jetkov/canary-pcb/Fabrication/PCBWay Gerbers/Canary-BOM-Processed.xlsx

Reference(s) | Value | Qty | Part Number | Manufacturer | Description
C1, C2, C4, C8, C11, C12, C14, C17 | 0.1u | 8 | CL05A104KP5NNNC | Samsung Electro-Mechanics | CAP CER 0.1UF 10V X5R 0402
C3, C9, C10, C15, C19, C23, C26 | 1u | 7 | CL05A105KP5NNNC | Samsung Electro-Mechanics | CAP CER 1UF 10V X5R 0402
C6, C7 | 12pF | 2 | CL05C120JB5NNNC | Samsung Electro-Mechanics | CAP CER 12PF 50V C0G/NP0 0402
C18, C20 | 10u | 2 | CL10A106MP8NNNC | Samsung Electro-Mechanics | CAP CER 10UF 10V X5R 0603
C21, C24 | 4.7u | 2 | CL05A475MP5NRNC | Samsung Electro-Mechanics | CAP CER 4.7UF 10V X5R 0402
C22, C25 | 22u | 2 | GRM188R61A226ME15D | Murata Electronics | CAP CER 22UF 10V X5R 0603
D1 | GREEN | 1 | 155124VS73200 | Wurth Elektronik | LED GREEN CLEAR 1204 SMD R/A
D2 | YELLOW | 1 | 155124YS73200 | Wurth Elektronik | LED YELLOW CLEAR 1204 SMD R/A
D3 | RED | 1 | 155124RS73200 | Wurth Elektronik | LED RED CLEAR 1204 SMD R/A
D4 | D_Schottky | 1 | PMEG2010EA,135 | Nexperia USA Inc. | DIODE SCHOTTKY 20V 1A SOD323
D5, D6, D7 | D_Schottky_ALT | 3 | NSPU3051N2T5G | ON Semiconductor | TVS DIODE 5.5V 9.5V 2X2DFN
J3 | USB4125-GF-A | 1 | USB4125-GF-A | GCT | USB C REC, GF, RA, 6P, SMT, TH S
J4 | S2B-PH-SM4-TB | 1 | S2B-PH-SM4-TB(LF)(SN) | JST Sales America Inc. | CONN HEADER SMD R/A 2POS 2MM
L1 | 2.2u | 1 | MAMK2520T2R2M | Taiyo Yuden | FIXED IND 2.2UH 1.9A 117 MOHM
L2 | 4.7u | 1 | LQH3NPZ4R7MMEL | Murata Electronics | FIXED IND 4.7UH 1A 120 MOHM SMD
LS1 | PKMCS0909E4000-R1 | 1 | PKMCS0909E4000-R1 | Murata Electronics | AUDIO PIEZO TRANSDUCER 12.5V SMD
Q1, Q3 | PMN30UNX | 2 | PMN30UNX | Nexperia USA Inc. | MOSFET N-CH 30V 4.5A 6TSOP
Q2 | PMN42XPEAH | 1 | PMN42XPEAH | Nexperia USA Inc. | MOSFET P-CH 20V 5.7A 6TSOP
R1, R13, R18, R26 | 2M | 4 | RMCF0402FT2M00 | Stackpole Electronics Inc | RES 2M OHM 1% 1/16W 0402
R2 | 2.4M | 1 | RMCF0402FT2M40 | Stackpole Electronics Inc | RES 2.4M OHM 1% 1/16W 0402
R3, R5, R6, R24 | 180k | 4 | RMCF0402FT180K | Stackpole Electronics Inc | RES 180K OHM 1% 1/16W 0402
R4, R7, R27 | 10k | 3 | RMCF0402FT10K0 | Stackpole Electronics Inc | RES 10K OHM 1% 1/16W 0402
R8, R9, R10, R11 | 470R | 4 | RMCF0402FT470R | Stackpole Electronics Inc | RES 470 OHM 1% 1/16W 0402
R12 | 499R | 1 | RMCF0402FT499R | Stackpole Electronics Inc | RES 499 OHM 1% 1/16W 0402
R15 | 499k | 1 | RMCF0402FT499K | Stackpole Electronics Inc | RES 499K OHM 1% 1/16W 0402
R16 | 49R9 | 1 | RMCF0402FT49R9 | Stackpole Electronics Inc | RES 49.9 OHM 1% 1/16W 0402
R19, R20 | 5.1k | 2 | RMCF0402FT5K10 | Stackpole Electronics Inc | RES 5.1K OHM 1% 1/16W 0402
R21, R30 | 487k | 2 | RMCF0402FT487K | Stackpole Electronics Inc | RES 487K OHM 1% 1/16W 0402
R22 | 86.6k | 1 | RMCF0402FT86K6 | Stackpole Electronics Inc | RES 86.6K OHM 1% 1/16W 0402
R23 | 300k | 1 | RMCF0402FT300K | Stackpole Electronics Inc | RES 300K OHM 1% 1/16W 0402
R25 | 0R | 1 | RMCF0402ZT0R00 | Stackpole Electronics Inc | RES 0 OHM JUMPER 1/16W 0402
R28 | 9.1k | 1 | RMCF0402FT9K10 | Stackpole Electronics Inc | RES 9.1K OHM 1% 1/16W 0402
R29 | 3k | 1 | RMCF0402FT3K00 | Stackpole Electronics Inc | RES 3K OHM 1% 1/16W 0402
U1 | BMD-300-A-R | 1 | BMD-300-A-R | U-Blox | RX TXRX MOD BLE 5.0 NORDIC SMD
U3 | SHTC3 | 1 | SHTC3 | Sensirion AG | SENSOR HUMI/TEMP I2C 2% SMD
U4 | SGP40 | 1 | SGP40-D-R4 | Sensirion AG | AIR QUALITY GAS SENSOR FOR VOC'S
U5 | MAX6071BAUT21T | 1 | MAX6071BAUT21+T | Maxim Integrated | IC VREF SERIES 0.08% SOT23-6
U6 | LMP91000 | 1 | LMP91000SD/NOPB | Texas Instruments | IC AFE 1 CHAN 8BIT 14WSON
U8 | MCP6041T-I_OT | 1 | MCP6041T-I/OT | Microchip Technology | IC OPAMP GP 1 CIRCUIT SOT23-5
U9 | RT6150AGQW | 1 | RT6150AGQW | Richtek USA Inc. | IC REG BCK BST ADJ 800MA 10WDFN
U10 | LP5907MFX-3.2 | 1 | LP5907MFX-3.2/NOPB | Texas Instruments | IC REG LINEAR 3.2V 250MA SOT23-5
U11 | MCP73831T-2ATI_OT | 1 | MCP73831T-2ATI/OT | Microchip Technology | IC BATT CNTL LI-ION 1CEL SOT23-5
U12 | MIC2288YD5 | 1 | MIC2288YD5-TR | Microchip Technology | IC REG BOOST ADJ 1.2A TSOT23-5
Y1 | 32.7680 kHz | 1 | ECS-.327-9-12-C-TR | ECS Inc. | CRYSTAL 32.7680KHZ 9PF 10PPM SMD
J1 | DNP | 1
J2 | DNP | 1
SW1 | DNP | 1
C5, C13, C16 | DNP | 3
R14, R17 | DNP | 2
S1 | DNP | 1
U2 | DNP | 1
U7 | DNP | 1
FID1, FID2, FID3, FID4, FID5, FID6 | Fiducial | 6
H1, H2 | MountingHole | 2
LOGO1 | CANARY-LOGO | 1
Source: | C:\Users\Alex\Documents\KiCAD\Canary\Canary.sch
Date: | 2021-03-02 04:23
Tool: | Eeschema (5.1.9)-1
Generator: | C:\Users\Alex\Documents\KiCAD\JetkovKiCADLib\Scripts/jetkov_bom_csv.py
Component Count: | 97
Populated Component Count: | 77
