jetkov/canary-pcb/Canary.kicad_pcb

## KiCad design Canary.kicad_pcb (2021-03-02)

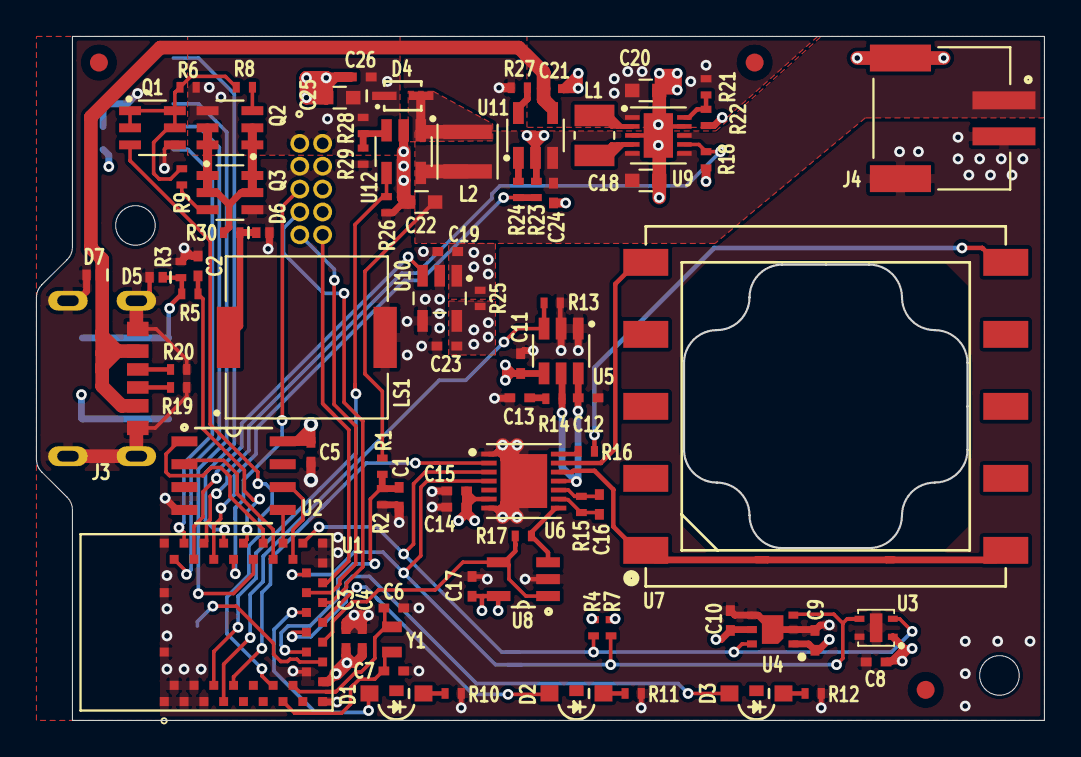
[picture p4: board Canary.kicad_pcb from above]

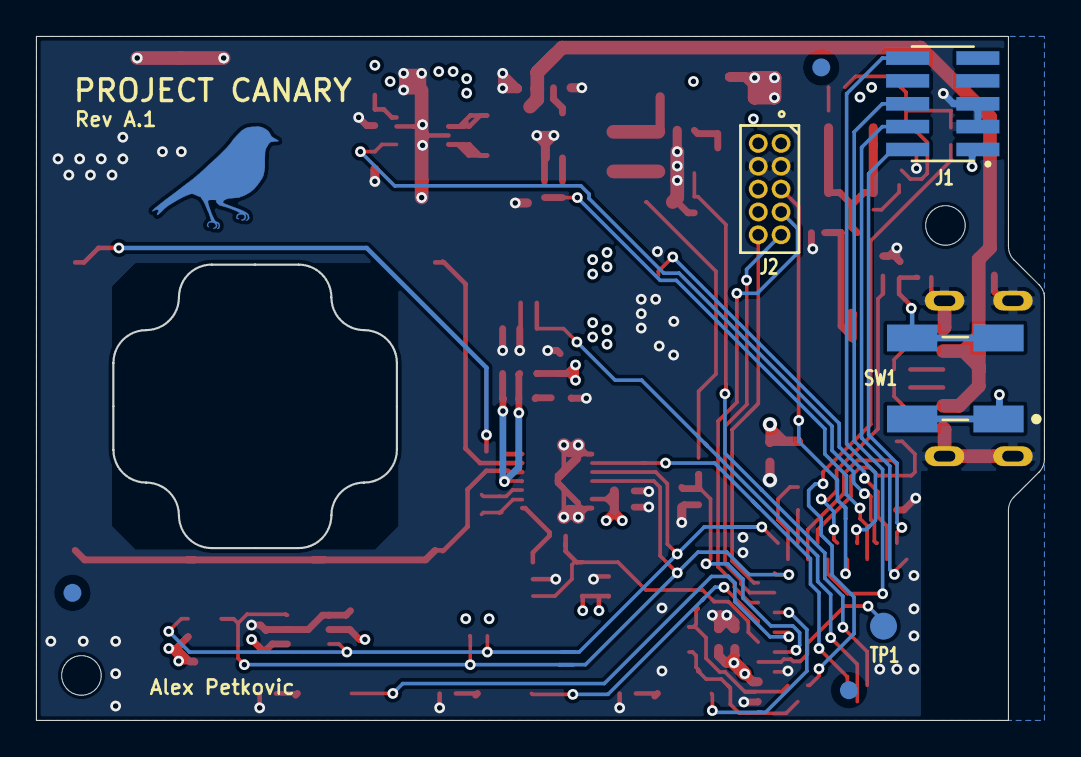
[picture p5: board Canary.kicad_pcb from below]

Board: 4 copper layers, 56.0 x 38.0 mm, 98 parts (8 on the bottom side), 63 nets.

Parts:
C1, C2, C4, C8, C11, C12, C14, C17: 0.1u; C_0402_NoSilk
C3, C9, C10, C15, C19, C23, C26: 1u; C_0402_NoSilk
C5, C13, C16: DNP; C_0402_NoSilk
C6, C7: 12pF; C_0402_NoSilk
C18, C20: 10u; C_0603
C21, C24: 4.7u; C_0402_NoSilk
C22, C25: 22u; C_0603
D1: GREEN; 155124xx73200
D2: YELLOW; 155124xx73200
D3: RED; 155124xx73200
D4: D_Schottky; PMEG2010EA
D5, D6, D7: D_Schottky_ALT; NSPU3051
FID1, FID2, FID3, FID4, FID5, FID6: Fiducial; Fiducial_1mm_Dia_2mm_Outer
H1, H2: MountingHole; MountingHole_2.2mm_M2
J1: CONN_ARM_CM_JTAG_SWD_10; 20021121-00010XXLFc
J2: 20021311-00010T4LF
J3: USB4125-GF-A
J4: S2B-PH-SM4-TB; JST_S2B-PH-SM4-TB
L1: 2.2u; MAMK2520T2R2M
L2: 4.7u; LQH3NPZ4R7MMEL
LOGO1: CANARY-LOGO
LS1: PKMCS0909E4000-R1
Q1, Q3: PMN30UNX; PMN-NXP-TSOP6-SOT457
Q2: PMN42XPEAH; PMN-NXP-TSOP6-SOT457
R1, R13, R18, R26: 2M; R_0402_NoSilk
R2: 2.4M; R_0402_NoSilk
R3, R5, R6, R24: 180k; R_0402_NoSilk
R4, R7, R27: 10k; R_0402_NoSilk
R8, R9, R10, R11: 470R; R_0402_NoSilk
R12: 499R; R_0402_NoSilk
R14, R17: DNP; R_0402_NoSilk
R15: 499k; R_0402_NoSilk
R16: 49R9; R_0402_NoSilk
R19, R20: 5.1k; R_0402_NoSilk
R21, R30: 487k; R_0402_NoSilk
R22: 86.6k; R_0402_NoSilk
R23: 300k; R_0402_NoSilk
R25: 0R; R_0402_NoSilk
R28: 9.1k; R_0402_NoSilk
R29: 3k; R_0402_NoSilk
S1: DNP; SM-UART-04L
SW1: TL3301SPF160QJ; TL3301EF160QJ
TP1: TestPoint; Measurement_Point_Round-SMD-Pad_Small
U1: BMD-300-A-R
U2: DNP; MX25V1006FM1I
U3: SHTC3
U4: SGP40; SGP40-D-R4
U5: MAX6071BAUT21T; MAX6071BAUT21
U6: LMP91000
U7: DNP; SPEC-110-902
U8: MCP6041T-I_OT
U9: RT6150AGQW
U10: LP5907MFX-3.2; LP5907MFX
U11: MCP73831T-2ATI_OT; MCP7383xx-xxxx_OT
U12: MIC2288YD5
Y1: 32.7680 kHz; ECS-327-9-12-C-TR

Connections:
3V3_PS: R18.1, U1.41, U9.7
5V_EN: R26.1, U1.6, U12.4
+3V3: C3.1, C4.1, C5.1, C19.1, C20.1, J1.1, R21.1, R25.2, SW1.1, SW1.2, U1.17, U2.8, U9.1, U10.1
+5V: C25.1, C26.1, D4.1, J2.1, J2.2, Q2.4, R6.1, R28.1
+BATT: C18.1, C22.1, C24.1, J4.1, L2.1, R1.2, U9.5, U9.6, U9.8, U11.3, U12.5
/BAT_DIV: C1.1, R1.1, R2.1, U1.20
/NG: Q3.3, R9.2
/PDRIVE: Q1.1, Q1.2, Q1.5, Q1.6, R6.2, R8.1, R9.1
/PDRIVE_O: D6.1, LS1.1, R30.2
/PG: Q2.3, R8.2
/Potentiostat/CE: R16.2, U6.14
/Potentiostat/FILT_C1: C16.2, R15.2, U6.10
/Potentiostat/FILT_C2: C16.1, R15.1, U6.9
/Potentiostat/SPEC_CE: R16.1, U7.6
/Potentiostat/SPEC_RE: U6.13, U7.5
/Potentiostat/SPEC_WE: U6.12, U7.1, U7.10
/Power/CPR: R27.1, U11.5
/Power/CST: R24.2, U11.1
/Power/HVR_FB: R28.2, R29.1, U12.3
/Power/HVR_SW: D4.2, L2.2, U12.1
/Power/LVR_FB: R21.2, R22.1, U9.10
/Power/LVR_LX1: L1.1, U9.4
/Power/LVR_LX2: L1.2, U9.2
/Power/USB_CC1: J3.A5, R20.1
/Power/USB_CC2: J3.B5, R19.1
/RBTN: D5.1, R3.1, R5.1, SW1.3, SW1.4
/XTAL1: C7.1, U1.13, Y1.2
/XTAL2: C6.2, U1.14, Y1.1
BUTTON: C2.1, R5.2, U1.37
CHG_STAT: R23.1, R24.1, U1.40
GND: C1.2, C2.2, C3.2, C4.2, C5.2, C6.1, C7.2, C8.2, C9.2, C10.2, C11.2, C12.2, C13.2, C14.2, C15.2, C17.2, C18.2, C19.2, C20.2, C21.2, C22.2, C23.2, C24.2, C25.2, C26.2, D5.2, D6.2, D7.2, J1.3, J1.5, J2.3, J2.4, J3.A12, J3.B12, J3.S1, J3.S2, J3.S3, J3.S4, J4.2, J4.S1, LS1.2, Q1.4, Q3.4, R2.2, R3.2, R10.2, R11.2, R12.2, R13.2, R18.2, R19.2, R20.2, R22.2, R23.2, R26.2, R27.2, R29.2, U1.1, U1.2, U1.3, U1.4, U1.5, U1.16, U1.18, U1.29, U1.30, U1.45, U1.46, U1.47, U2.4, U3.4, U3.5, U4.2, U4.4, U4.7, U5.1, U5.2, U6.1, U6.7, U6.15, U8.2, U9.3, U9.9, U9.11, U10.2, U10.4, U11.2, U12.2
I2C_SCL: R4.2, U1.31, U3.2, U4.6, U6.3
I2C_SDA: R7.2, U1.28, U3.3, U4.3, U6.4
LED_AMBER: D2.2, U1.23
LED_GREEN: D1.2, U1.24
LED_RED: D3.2, U1.22
LMP_VOUT: R17.1, U6.8, U8.3
LMP_VOUT_B: R17.2, U1.21, U8.1, U8.4
unnamed: C13.1, R14.2
unnamed: D1.1, R10.1
unnamed: D2.1, R11.1
unnamed: D3.1, R12.1
unnamed: Q2.1, Q2.2, Q2.5, Q2.6, Q3.1, Q3.2, Q3.5, Q3.6, R30.1
unnamed: TP1.1, U1.19
PIEZO_PWM: Q1.3, U1.12
PM_UART_RXD: J2.7, U1.25
PM_UART_TXD: J2.9, U1.26
SPI_CLK: U1.32, U2.6
SPI_MISO: U1.34, U2.2
SPI_MOSI: U1.33, U2.5
SWDCLK: J1.4, U1.44
SWDIO: J1.2, U1.43
SWO: J1.6, U1.36
VBUS: C21.1, D7.1, J3.A9, J3.B9, U11.4
VDD: C8.1, C9.1, C10.1, C11.1, C14.1, C15.1, C17.1, C23.1, R4.1, R7.1, R25.1, U3.1, U4.1, U4.5, U5.4, U6.6, U8.5, U10.5
VDD_EN: U1.42, U10.3
VREF: C12.1, R14.1, U5.5, U5.6, U6.11
VREF_EN: R13.1, U1.7, U5.3
~FLASH_CS~: U1.35, U2.1
~LMP_EN~: U1.8, U6.2
~PM_RST~: J2.5, U1.38
~PM_SLEEP~: J2.10, U1.27
~RESET~: J1.10, U1.39
