jetkov/canary-pcb/(commit log)

2021-02-24 Clean up, add notes
    [Canary.sch, Power.sch]
2021-02-24 Select caps
    [Canary.sch, Power.sch]
2021-02-24 cleanup, add inductors
    [Potentiostat.sch, Power.sch]
2021-02-24 Add diode info
    [Power.sch]
2021-02-24 Add pizeo
    [Canary.sch]
2021-02-24 Fix part info, start rough layout
    [Canary.kicad_pcb, Canary.sch, Potentiostat.sch, Power.sch]
2021-02-27 Adjust layour
    [Canary.kicad_pcb, Canary.sch]
2021-02-28 Update switch, placement adjustments
    [Canary.kicad_pcb, Canary.sch]
2021-02-28 Update switch
    [Canary.kicad_pcb]
2021-02-28 Almost final main component placement
    [Canary.kicad_pcb, Canary.sch]
2021-02-28 Board setup and rules
    [Canary.kicad_pcb]
2021-02-28 group components
    [Canary.kicad_pcb]
2021-02-28 Clean up schem, wire in button
    [Canary.kicad_pcb, Canary.sch, Power.sch]
2021-02-28 Spec LED resistors
    [Canary.sch]
2021-02-28 Resolve DRC errors and add proper flagging
    [Canary.sch, Power.sch]
2021-02-28 Review everything, ready for layout
    [Canary.kicad_pcb, Canary.sch, Potentiostat.sch]
2021-03-01 Reannotate, fix BMD reference
    [Canary.kicad_pcb, Canary.sch]
2021-03-01 layout wip
    [Canary.kicad_pcb, Canary.sch, Potentiostat.sch, Power.sch]
2021-03-01 routing wip
    [Canary.kicad_pcb]
2021-03-01 Add resistor details
    [Canary.sch, Potentiostat.sch, Power.sch]
2021-03-01 Fill in component info, reduce uniqe resistors. cleanup
    [Canary.sch, Potentiostat.sch, Power.sch]
2021-03-01 Info tweaks
    [Canary.kicad_pcb, Canary.sch, Potentiostat.sch]
2021-03-02 Routing done (needs review)
    [Canary.kicad_pcb]
2021-03-02 Resolve DRC errors
    [Canary.kicad_pcb]
2021-03-02 Change crystal
    [Canary.kicad_pcb, Canary.sch]
2021-03-02 Change crystal again
    [Canary.kicad_pcb, Canary.sch]
2021-03-02 Add canary logo
    [Canary.kicad_pcb, Canary.sch]
2021-03-02 Add TVS diodes, resistor for piezo drive, and test point
    [Canary.sch, Power.sch]
2021-03-02 Add TVS diodes, piezo resistor, testpoint, cleanup
    [Canary.kicad_pcb]
2021-03-02 Clean up silks, add fiducials
    [Canary.kicad_pcb, Canary.sch]
2021-03-02 Tweak component infos
    [Canary.sch, Potentiostat.sch]
2021-03-02 Prepare for fab export
    [Canary-BOM-processed.xlsx, Canary-BOM-raw.csv, Canary.kicad_pcb, Canary.sch, Potentiostat.sch, Power.sch]
2021-03-02 Generate gerbers
    [Canary-B_Cu.gbr, Canary-B_Mask.gbr, Canary-B_SilkS.gbr, Canary-Edge_Cuts.gbr, Canary-F_Cu.gbr, Canary-F_Mask.gbr, Canary-F_Paste.gbr, Canary-F_SilkS.gbr]
2021-03-02 Regenerate Gerbers using PCBWay process
    [Canary-BOM-processed.xlsx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]
2021-03-02 Clean up silk, add page info
    [Canary.kicad_pcb]
2021-03-02 Cleanup tracks/vias
    [Canary.kicad_pcb]
2021-03-02 Make USB conn SMD part, add paste to THP
    [Canary.kicad_pcb]
2021-03-02 Rerun gerber export
    [Canary-B_Cu.gbl, Canary-B_Mask.gbs, Canary-B_SilkS.gbo, Canary-Edge_Cuts.gm1, Canary-F_Cu.gtl, Canary-F_Mask.gts, Canary-F_Paste.gtp, Canary-F_SilkS.gto]
2021-03-02 Set logo virtual
    [Canary.kicad_pcb]
2021-03-02 Gerber zips
    [Canary-BOM-processed.xlsx]
